prasadp4009/tt_um_pemu/docs/OPEN_ITEMS_AUDIT.md

# tt_um_pemu — Functionality Open-Items Audit, 2026-10-29

Branch: `docs/readme-site` (from `main@abafd1c`, the merged IMEM-512 design).
Scope rule for this pass: **no changes to `src/` RTL or `src/config.json`, ever.**
Test-only and docs-only changes only. Any RTL change below is a **proposal**,
never a commit. Nothing was merged to `main`; `main` was not touched;
repo visibility and Pages settings were not touched; no force pushes.

Evidence base: `SUBMISSION_READINESS_2026-10-27.md`, `PUSH_PREP_AUDIT_2026-10-26.md`
§15–§18, `FINAL_STATS.md` §5/§8, `ISA_v0.2.md`, `ISA_v0.3_NOTE.md`,
`STRETCH_PROTOCOL_TESTS_2026-10-27.md` + `stretch_results/`, plus fresh
re-runs done for this audit (see §4). All file paths below are repo paths
unless prefixed `masters:` (the firmware masters are now committed to this repo under `firmware/` - strip the prefix to resolve the path).

## 1. Classification key

- **(a) IMPACTS CHIP FUNCTIONALITY** — must close, or bound with proof.
- **(b) DOCUMENTED LIMITATION** — behavior as-designed / as-built and bounded;
  stated plainly, with the exact bound.
- **(c) NON-FUNCTIONAL** — cosmetic / admin / score / verification depth;
  not a chip bug.

## 2. Disposition table

| # | Item | Class | Disposition (evidence / resolution) |
|---|---|---|---|
| 1 | T17 WAIT-overflow semantics (tsel 2/3: 65536 / 1048576-cycle timeouts vs 16-bit Rd) | **(a) decision item — bounded, not silently wrong** | **What the hardware DOES today (read from RTL, proven by bench):** `src/tt_um_pemu_pe.v` implements only two presets: `wait_timeout_r <= instr[13] ? 4096 : 256` (13-bit). `tsel[1]` (`instr[14]`) is **ignored for the timeout and sets CONFIG_ERR sticky** (PE header: "T17-OPEN: tsel[1] ignored for the timeout; flag it instead of inventing semantics"). So: tsel 0 → 256, tsel 1 → 4096, tsel 2 → 256 + CONFIG_ERR, tsel 3 → 4096 + CONFIG_ERR. Elapsed is written as `{3'd0, ecnt}+1` on a hit or `{3'd0, wait_timeout_r}` on timeout; the largest value ever written is **4096**, so **no wrap and no overflow can occur in the as-built design** — the 16-bit Rd overflow question only arises if the 65536/1M presets are ever implemented. The standing "saturate at 0xFFFF" recommendation is therefore **not implemented, and not applicable to the shipped behavior**; it is the specified behavior for Option B below. Bench proof this pass: `test/tb_pe.v` Part 4 checks tsel=1 at exactly 4096 cycles / elapsed=4096 / TIMEOUT set, and tsel=2/3 CONFIG_ERR set; full bench re-run 2026-10-29: **RESULT: PASS (363 checks)**. **No RTL change made.** Decision for the ISA lead (see §3.1): Option A (recommended for submission) — rule tsel 2/3 out of the submitted ISA, document CONFIG_ERR+fallback as the behavior, firmware chains tsel=1 waits (as the UART break rule already does); zero cost. Option B — implement the presets with saturation; exact fix + re-verification cost in §3.1. **Also note a numbering collision:** ISA_v0.2 §"proof obligations" reuses the label T17 for Observer adjacency (trigger→commit ≤ K=6); that is a different, already-specified item (R-13) and is not this item. |
| 2 | CAN DLC ≤ 2 cap | **(b) DOCUMENTED LIMITATION** | **Bound: max DLC = 2.** Structural cause confirmed from `masters:firmware/can/can.asm` header + `stretch_results/can.md` §5: Tarang has **no data RAM** and all **16 GPRs are fully allocated** (register map in can.asm); the destuffed data stream (up to 16 bits) must survive SOF..DLC intact in a register while the DLC field's own shifter, the ID shifter, and the arbitration flag are also live; the only spare byte-wide homes are observer sregs, and a 16-bit stream cannot be reloaded from 8-bit sregs inside the inter-bit gap. DLC > 2 arguments are consumed and discarded and the firmware PUSHes 0xFFFF. The 255/256-word budget pressure at baseline was a second, contributing reason; **the GPR reason is binding, so IMEM-512 does not lift the cap.** All other CAN fields are DLC-independent loops, so this is a data-length limit only: CAN 2.0A TX + ACK + arbitration at 1 Mb/s is proven (wire CRC 0x33ea == recomputed). **Redesign is OUT of scope:** it would need a data-RAM-backed buffer or an additional 16-bit stream register plus a re-timed cell loop and a firmware rewrite. Plain-language bound also in `docs/CHARACTERIZED_LIMITS.md`. |
| 3a | Golden sub-check: test_spi 1-cycle stale assertion | **(c) checker bug — FIXED this pass** | **Root cause (harness, not chip):** the checker expected inter-byte SCLK gap 57 cycles / cycles-per-byte 407 (= 400+7), but the golden model itself produces **58 / 408 (= 400+8)** — exactly +1 cycle in the byte prologue/epilogue path. Re-run before fix (2026-10-29): `SCLK period deviations (want 50, 57 at byte boundary): [(7, 58)]`, `cycles/byte=408, want 407`; **every functional check passed** (MOSI bytes 0xA5/0x3C, TX words 0x5A/0xC3 + statuses, CS# windows, duty 25/25, halt, no stickies). Cross-proof the design is not at fault: co-sim SPI is **855/855 cycle-exact RTL-vs-golden**, so RTL and golden model agree; only the checker's expectation was stale. **Fix:** `masters:firmware/tests/test_spi.py` 57→58, 407→408 (exact patch in `docs/open-items/test_spi_checker_fix.patch` on this branch; the golden tests now live in the repo at `firmware/tests/`). Re-run after fix: **[PASS] spi, 881 cycles, halted, zero deviation** (`14x50c + 1x58c`, `cycles/byte = 408`). Repo `docs/FIRMWARE.md` SPI line corrected on this branch (407→408). The `firmware/spi/spi.asm` header comment now says 408/58, consistent with the corrected expectation (docs-only change; it does not affect any shipped hex). |
| 3b | Golden sub-check: test_uart TX-underrun sub-check | **(b) DOCUMENTED FIRMWARE LIMITATION — not a checker fix** | **Root cause (real firmware behavior, not a stale expectation):** the test expects a starved host (N=2, one data word) → PUSH 0xFFFD, no hang. Re-run 2026-10-29 reproduces the failure exactly: `TX underrun -> PUSH 0xFFFD, no hang (got [])`, `underrun run halted` FAIL; all other UART sub-checks pass. Mechanism: the RACE FIX (2026-09-27) guards **every** PULL with an RXNE wait (`jmp tx_d_have, rxne; jmp txloop` in `masters:firmware/uart/uart.asm`), so the TX loop **blocks forever waiting for byte 2** and never executes a PULL on an empty FIFO; the post-PULL RX_UNDERRUN check and the `tx_underrun` 0xFFFD path are, in the firmware header's own words, "retained as a safety net (unreachable in normal operation)". The golden model (`sim.py` PULL-on-empty → RX_UNDERRUN sticky) is correct but is never exercised on this path, and the peer never sees EVT 0 so it never pushes the halt word — hence "no hang" fails by construction. **No checker change made** (rewriting the expectation to "hangs" would gut the test) and **no firmware change made** (that would be a behavior change to shipped firmware, not a checker fix). **Documented bound:** in the UART TX demo, host starvation blocks in the RXNE wait; recovery is supplying the missing word (or host reset/reload) — there is no 0xFFFD abort on this path. Repo `docs/FIRMWARE.md` line "TX underrun → 0xFFFD, no hang" corrected on this branch to state the blocking behavior. Proposal + cost if the 0xFFFD abort is ever wanted: add a WAIT-bounded starvation timeout to the TX loop in firmware (firmware-only, no RTL), re-assemble, re-run golden + co-sim (UART trace re-record, 8,747 cycles), full regression gate; decision for the firmware owner. This is a firmware-demo limitation, not a PE bug: the PE executes the wait loop exactly as written. |
| 4 | Slow-corner timing: 512-build WNS −2.824 ns, 112 violators | **(a) genuine silicon-risk item — mitigated by clock guidance, redesign OUT of scope** | Numbers are the **IMEM-512 (submittable) run** (`FINAL_STATS.md` §8, run 40699493628): slow corner (nom_slow 1.08 V, 125 °C) setup WNS **−2.824 ns**, TNS −157.48 ns, **112 violators** (110/112 from `u_imem/A_DOUT[17]`, 2 reg-out from `A_DOUT[18]` — same fetch-path single-bit class as the 256 baseline's 131 violators all from A_DOUT[18]). Implied slow-corner fmax = 1/(20 ns + 2.824 ns) ≈ **43.8 MHz** (baseline was −2.933 ns / 131 / ≈43.6 MHz). Typical (+5.713 ns) and fast (+8.578 ns) corners are clean; **hold is clean at all corners**. The competition imposes **no clock target** (designer-chosen 50 MHz in `info.yaml`); these are checker warnings in this flow, not flow errors, and GDS/LVS/DRC/antenna/IR all pass. **Characterized guidance (also in `docs/CHARACTERIZED_LIMITS.md`): run at ≤ 43.8 MHz for guaranteed setup across all corners; 50 MHz is met with margin at typical and fast corners only.** Timing-closure redesign (fanout buffering/replication of the fetch net, or fetch pipelining) is OUT of scope for this pass and is the one item that would need a new hardening round if pursued. Max-slew slow-corner warnings (779, vs 587 baseline) are the same warning class, not errors. |
| 5 | SPI @125 MHz baseline anomaly (deterministic FAIL 13/15, fail_code 0x13) | **(b) OBSERVED, NOT ROOT-CAUSED — not claimed fixed** | Baseline (256-word) behavior: deterministic FAIL at 125 MHz, fail_code 0x13 (13/15 runs; working suspicion was MMCM/pin-sampling, never proven). On the 512 build it **did not reproduce: PASS 2/2** — `fpga/logs/test512_spi_125.log` and `test512_spi_125_rerun.log`, both `PASS: milestones 0x7fff as expected, signature=0xa6b864d9` (the 50 MHz reference signature, bit-identical). **Disposition, stated exactly: observed, not root-caused; no fix was attempted and none is claimed.** The re-synthesized 512 build differs in LUTRAM placement/inference, which is a hypothesis for the difference, not a root cause. The anomaly stays on the record as a 125 MHz operating-condition caveat: the proven operating point is 50 MHz (15-milestone SPI proof); 125 MHz passed twice on the 512 build but is not characterized as a guaranteed operating point. |
| 6 | Observer hardware capture (real trace-SRAM dump from the board) | **(c) SCORE ITEM — not done; NOT feasible in this pass without a harness build** | Status unchanged: Observer works in sim/co-sim (bench `tb_observer`, 35 checks; co-sim traces), but **no hardware trace-SRAM capture has ever been demonstrated**. Feasibility assessment (this pass, no RTL touched): **not feasible as a small add-on.** The programmed Zybo harness (`fpga/emu_tt_top.v` + `fpga/emu_tt_loader.v`, bitstream `fpga/emu_tt_50.bit`) has **no RD_TRACE path**: the loader FSM implements LOAD_IMEM / VERIFY / GO / TRANSFER / RD_TXFIFO only (grep: zero RD_TRACE references in the loader), and its VIO observation registers (`dbg0/dbg1/dbg2`) carry loader/SPI state, not trace data. The host protocol itself **does** support RD_TRACE (command 0x07 in `src/tt_um_pemu_host.v`, S_RSI/S_RCT/S_RPRE/S_RTRC/S_RTRD/S_RTRN/S_RTRP states), and PE firmware **can** configure the Observer via MSR (TRIG_MODE/EDGE_MASK/OBS_CTL sequence), so the silicon path exists — but using it on the board needs (1) a new firmware image that configures the Observer then runs a protocol and halts, (2) a loader-FSM extension to issue RD_TRACE after halt and stream the 5-byte entries out via VIO, and (3) a Vivado rebuild + Zybo run + validation. That is a scoped harness build (firmware + loader + rebuild + validation; Vivado 2026.1 + license confirmed present on starklabs), **not** a capture that can be produced from the existing bitstream — BRAM contents are not readable over JTAG without a debug path. **Left as the named remaining score item**, with the scoped proposal above. No capture evidence is committed by this pass, and none is claimed. |
| 7a | T17 siblings T5/T6/T7/T10/T11 (ISA §8 TBDs) | **(b) IMPLEMENTED BEHAVIOR — ISA table stale, no RTL change needed** | RTL already defines each: T5 unallocated sregs → **read-as-zero** (`sreg_read` default); T6 illegal opcodes 24–63 → **NOP (1+d) + CONFIG_ERR**; T7 logic fn=11 → **executed as AND + CONFIG_ERR** (PE header); T10 RET on empty stack → **NOP + CONFIG_ERR**; T11 CALL stack overflow → **drop call + CONFIG_ERR** (not the proposed STATUS[6]=CALL_OVF — the flag was never assigned, CONFIG_ERR is the implemented signal). The ISA §8 table still lists them "open"; a doc addendum (this audit + `docs/CHARACTERIZED_LIMITS.md`) closes the table. No RTL change, no re-verification beyond the existing benches that already cover these paths. |
| 7b | T17 siblings T2/P1 (SLEEP cycle-count tension), T3, T4, T8, T9, T12, T13, T14, T15, T16 | **(b)/(c) — spec tension / unruled / verification depth; none is an observed chip misbehavior** | T2/P1: SLEEP is built as exactly `1+imm13` with `d` reserved_zero ignored; the tension is between two spec sentences ("every insn = 1+delay" vs SLEEP = 1+imm13), not between RTL and test — doc/contract wording item for the ISA lead + formal (F1 must encode the resolution). T3 (CFG_DIRTY clear condition), T4 (OBS_ARM one-shot vs sticky), T8 (PDIR/PMASK/PMODE reset-default confirmation), T16 (HLT/GO wake accounting): unruled, no failing test or observed misbehavior on record; ruling needed before formal closure, not a submission gate. T9 (formal SVA bind names): verification depth. T12 (pin-effect list naming only PSET/PSETR): **doc fix only** — add PDIR/PMODE to ARCHITECTURE §2.2.2 list. T13 (Q5 sequence triggers), T15 (watermark async push): feature proposals, out of scope; sticky-poll TRACE_WM works as built. T14 (Q4 PE-side trace read): decided v0.2 — host-only read stands; revisit gate not met. |
| 7c | PULSE-mode PIN_SEL tied to 0 (top-level integration deviation) | **(b) DOCUMENTED LIMITATION** | `src/tt_um_pemu.v` ties observer `pin_sel` to `3'b0` because the PE port list does not expose `pin_sel_r` (PE sreg PIN_SEL 0x0A itself reads/writes correctly). Consequence, bounded: **PULSE-mode triggering watches pin 0 only**, regardless of the MSR PIN_SEL value; EDGE and PATTERN modes are unaffected (masks only). Proposal (RTL, not done): add a `pin_sel_r` PE output and wire it through; re-verification = observer bench + top bench + CI round. Until then the bound is: PULSE source = pin 0. |
| 7d | TRACE_WM semantics (D7 erratum) | **(b) RESOLVED, documented** | Resolved doc-side 2026-10-26: STATUS[12] TRACE_WM is sticky, cleared only by OBS_CLR (MSR OBS_CTL bit 2), not by STATUS W1C (bits [4:0] only). OBS_PTR saturates at 204, never wraps. No action. |
| 7e | USB RX / merged USB; 10BASE-T Ethernet | **(b) DOCUMENTED LIMITATIONS (firmware/scope, not chip bugs)** | Merged USB TX+RX in one image is proven on the 512 build (299-word merged image; 301-word variant proves `ahi=1` chunk-base load/verify on Zybo; co-sim usb_full 6,297 cycles). A complete USB device stack remains firmware work. 10BASE-T is not feasible on-chip on three independent grounds (Manchester half-bit 2.5 cycles on the 20 ns grid = ±10 ns jitter vs ±5.5 ns 802.3 limit; exact Manchester needs a 100 MHz grid vs ~43.8 MHz slow-corner fmax; 10BASE-T needs an analog PHY, not digital GPIO) — external-PHY-over-MII would work but is not an ISA achievement and is not claimed. |
| 7f | Formal competition entry (Jane Street form) | **(c) NON-FUNCTIONAL / ADMIN — OPEN, largest admin gap** | No formal entry submitted as of 2026-10-27; the 2026-09-27 competition-updates signup (prasadp4009@gmail.com) is not the entry. The form is not yet published by Jane Street; **deadline 2027-01-18**. Owner: Prasad (submitter). A perfect chip with no entry scores zero. |
| 7g | Viewer job / GitHub Pages | **(c) NON-FUNCTIONAL — OPEN, submitter's settings call** | Every CI round: gds ✅, precheck ✅ (9/9), gl_test ✅, test ✅, docs ✅, viewer ❌ — solely because GitHub Pages is not enabled on the private repo. Cosmetic (renders the GDS viewer page); the flow's own render PNG exists in run artifacts. Deliberately not changed in this pass (repo visibility/Pages settings out of scope). |
| 7h | Display-name rename (Tarang collision) | **(c) NON-FUNCTIONAL — undecided** | Another public project uses "Tarang". Repo name `tt_um_pemu` is fixed by Tiny Tapeout convention regardless; only the display name is at stake. No chip impact. |
| 7i | PROGRESS.md markers | **(c) NON-FUNCTIONAL — stale** | PROGRESS.md still shows Phase 6/7/8 "queued" markers that postdate completed work (RTL, verification, hardening all executed). Cosmetic tracker staleness; refresh is a Phase B docs task, not a chip item. |
| 7j | Local hardening (Phase 0, docker group) | **(c) NON-FUNCTIONAL — convenience, still blocked** | `jarvis` is not in the `docker` group on starklabs; unlock is `sudo usermod -aG docker jarvis` (~1 min, Prasad). CI hardening works (~40–70 min/run), so this is iteration convenience, not a blocker. |
| 7k | Upstream template issue (gl_test `sg13cmos5l_udp.v` omission) | **(c) NON-FUNCTIONAL — drafted, unfiled; repo-side fix in place** | Root cause was the Tiny Tapeout template Makefile omitting the PDK's mandatory sibling file (2,261 unknown-module errors). Repo-side one-line fix (commit e99ff28, `test/Makefile` GATES sources) is in place and gl_test is green on every round since; the durable upstream fix (draft issue text in the readiness doc) remains unfiled — upstream hygiene, not a chip item. |
| 7l | Phase 7 verification depth (formal timing contract, constrained-random, agentic campaign) | **(c) VERIFICATION DEPTH — queued, not started; not a chip bug** | Existing evidence is already strong (643 benches, formal 32/32 on the ISA-contract subset, co-sim 11/11 cycle-exact, 4 protocols on Zybo hardware + stretch protocols in sim). Phase 7 adds depth, not existence. Not attempted in this pass per instructions. |
| 7m | Vacuity code 0x0E vs 0xEE | **CLOSED** | Hardware produces 0xEE (HALT-status mismatch → T_DG diagnostic drain → do_fail(0xEE)); 0x0E was the ACK-timeout code only. `fpga/test_tt.tcl` expectation fixed on the 512 branch and re-proven on hardware; audit §18 records the semantics call closed. |
| 7n | Local-master housekeeping: `firmware/i2c/i2c.hex` stale vs `.asm` | **(c) NON-FUNCTIONAL — note only** | Repo `i2c.hex` matches the current `.asm` and is byte-identical to a fresh assembly, as are all repo hex files. The stale file is in local masters only; no shipped artifact is affected. |
| 7o | FPGA negative-WNS warning class (e.g. usb_full proj −5.837 ns) | **(c) NON-FUNCTIONAL for the ASIC** | FPGA-harness timing warnings (LUTRAM RMW paths); hardware passes regardless, as on the baseline. This is not ASIC STA — the ASIC timing verdict is item 4. |

## 3. RTL-needing proposals (NOT committed — decision items only)

### 3.1 T17 Option B — implement 65536/1M presets with saturation (only if the ISA lead wants the presets)

Exact fix (PE only, `src/tt_um_pemu_pe.v`):
1. Widen `wait_timeout_r` and `ecnt` from 13 bits to 21 bits (1,048,576 needs bit 20 for the value itself).
2. Timeout map: tsel 0 → 256, 1 → 4096, 2 → 65536, 3 → 1048576; remove the `instr[14]` CONFIG_ERR set for tsel 2/3 (keep CONFIG_ERR for genuinely reserved encodings elsewhere).
3. Elapsed write, both exits: `Rd <= min(elapsed, 16'hFFFF)` — i.e. on timeout write `16'hFFFF` (not the timeout value) with TIMEOUT sticky set; on a hit write `min(ecnt+1, 16'hFFFF)`. TIMEOUT sticky already disambiguates a saturated timeout from a genuine 0xFFFF hit only when combined with the sticky bit — document that TIMEOUT must be read alongside Rd for tsel 2/3.
4. Spec updates (docs-only, same change): ISA timeout table, T2, `isa_v0.2.yaml` `wait_tsel_map`, and the T17 row — a semantics change, so it forces an ISA version bump per ISA_v0.2 §10.

Re-verification cost: update `test/tb_pe.v` Part 4 (tsel 2/3 CONFIG_ERR checks become 65536/1048576-cycle timeout checks — 1M-cycle Verilator runs are cheap); update the golden model `sim.py` WAIT path and re-run all golden protocol tests; re-record any co-sim traces containing WAIT (cycle counts change only for tsel 2/3 images; none of the shipped protocol images use tsel 2/3 — UART uses tsel ≤ 1 everywhere per its header); full regression gate (643 benches, formal 32/32 incl. F4 WAIT properties, 11/11 co-sim); one CI round (gds/precheck/gl_test/test/docs, ~40–70 min). No GDS-significant change expected (small PE logic delta), but CI re-hardening is mandatory because `src/` changed. Zybo re-proof is not required unless firmware changes (it does not).

### 3.2 PULSE pin_sel wiring (item 7c)

Add a `pin_sel_r` output to the PE port list, wire it to the observer `pin_sel` input in `src/tt_um_pemu.v` (replacing the `3'b0` tie), re-run observer + top benches + one CI round. Small, but it is an RTL change and was not made in this pass.

### 3.3 UART TX starvation timeout (item 3b, firmware — not RTL)

If the 0xFFFD abort is wanted: add a WAIT-bounded starvation timeout to the TX data-wait loop in `masters:firmware/uart/uart.asm`, re-assemble, re-run golden UART + co-sim UART (8,747 cycles, trace re-record), full regression gate. Firmware-only; no `src/` change, but it does change a shipped `.hex`, so it needs the same gate discipline as an RTL change.

## 4. Local tests run for this audit (2026-10-29, branch `docs/readme-site` unless noted)

| Test | Result |
|---|---|
| `bash test/run_verilator.sh pe` (starklabs, Verilator 5.053) | **RESULT: PASS (363 checks)** — includes tsel=1 4096-cycle/elapsed/TIMEOUT checks and tsel=2/3 CONFIG_ERR checks (Part 4). `check()` sets a fail flag on any miss, so PASS means all of them passed. |
| Golden `test_spi.py` via `firmware/tools/tb.py run` — BEFORE checker fix | **FAIL, exactly as documented**: `SCLK period deviations (want 50, 57): [(7, 58)]`, `cycles/byte=408, want 407`; all functional checks passed. |
| Golden `test_spi.py` — AFTER checker fix (57→58, 407→408) | **[PASS] spi, 881 cycles, halted** — `14x50c + 1x58c`, `cycles/byte = 408`, zero deviation. |
| Golden `test_uart.py` via `tb.py run` — re-run, no changes | **FAIL only on the TX-underrun sub-check** (`PUSH 0xFFFD, no hang (got [])`, `underrun run halted` FAIL); every other UART sub-check passes (TX bytes/framing, RX words, EVT 0/1/2, zero warnings, WAIT latency 2 cycles, CAP ts match, RX sampling +1 cycle). |
| SPI @125 MHz log re-read (`fpga/logs/test512_spi_125.log`, `..._rerun.log`) | Both `PASS: milestones 0x7fff, signature=0xa6b864d9` — confirms the 2/2 non-reproduction cited in item 5. No new hardware run was made in this pass. |

No other local test was run in this pass. In particular: no Zybo run was attempted (item 6 needs a harness build first), no CI round was triggered (docs-only + patch-file changes do not alter hardening inputs; CI re-verification of the branch is a Phase B/C step if desired), and no RTL was modified, so no RTL re-verification was owed.

## 5. Bottom line — what still impacts chip functionality after this pass

**No unhandled chip-functionality bug remains.** The complete list of functionality-affecting items is:

1. **Slow-corner timing (item 4)** — the one genuine silicon-risk item: guaranteed setup across all corners needs **≤ 43.8 MHz**; 50 MHz is good at typical/fast only. Mitigation is the clock guidance, not a redesign (redesign out of scope).
2. **T17 (item 1)** — a decision item, not a bug: the as-built behavior (256/4096 + CONFIG_ERR fallback) is safe and proven; the ISA lead must choose Option A (rule the presets out, zero cost) or Option B (implement + saturate, cost in §3.1). Until ruled, firmware must not use tsel 2/3 expecting a 65536/1M timeout — it will get 256/4096 + CONFIG_ERR instead.
3. **Documented limitations (items 2, 3b, 5, 7c, 7e)** — CAN DLC ≤ 2; UART TX host-starvation blocks instead of aborting with 0xFFFD; SPI @125 MHz passed 2/2 on the 512 build but is observed-not-root-caused (proven point is 50 MHz); PULSE-mode trigger watches pin 0 only; full USB device stack / 10BASE-T out of scope. Each is bounded in `docs/CHARACTERIZED_LIMITS.md` with the exact behavior a user or judge will see.

Everything else in the table is non-functional, administrative, verification depth, or already closed. The remaining **score** item (not a chip bug) is the **Observer hardware capture (item 6)**; the remaining **admin** item is the **formal competition entry (item 7f, deadline 2027-01-18)**.
