prasadp4009/tt_um_pemu/docs/assets/chip_3d_view.png

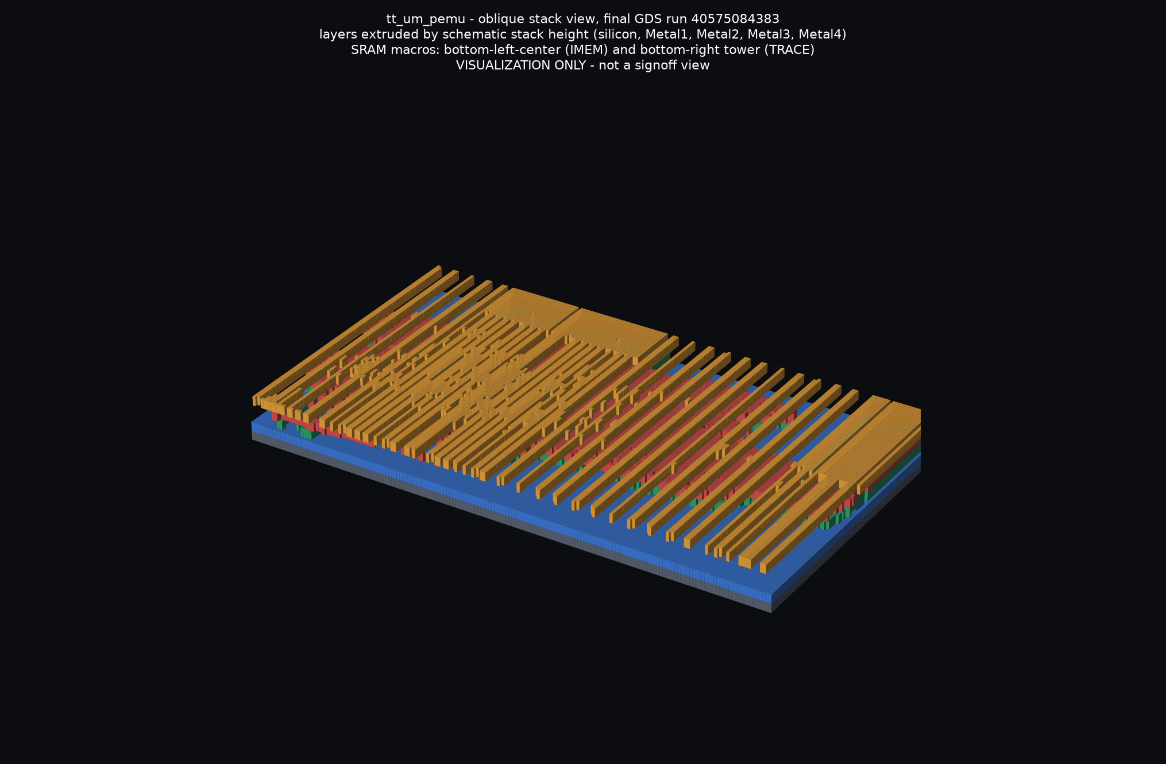
docs/assets/chip_3d_view.png
