prasadp4009/tt_um_pemu/test/synth/tt_flow/metrics.csv

Metric | Value
design__lint_error__count | 0
design__lint_timing_construct__count | 0
design__lint_warning__count | 2
design__inferred_latch__count | 0
design__instance__count | 11964
design__instance__area | 184656.742200
design__instance_unmapped__count | 0
synthesis__check_error__count | 0
