prasadp4009/tt_um_pemu/(commit log)

2026-09-27 Worker C (host): 2-wire host port, FIFOs, IMEM loader, trace readout
    - UART-style 10-bit framed host link on ui_in[0]/uo_out[0] with autobaud
    sync (0x00 NOP), default 64 clocks/bit, clamp 16..4096
    - Framed protocol [CMD][LEN][DATA]->[ACK][DATA]: NOP, LOAD_IMEM (PROG
    full-word prog_wen strobes), WR_RXFIFO (MSB-first, odd-pad 0x00,
    all-or-nothing), RD_TXFIFO, RD_TRACE (ret_count clamp + OBS_PTR),
    RD_STATUS, GO, HALT_REQ (accepted); unknown/bad-len -> NACK_ERR
    - 16x16 RX/TX FIFOs: PE push-full drops, pull-empty returns 0, never stalls
    - RD_STATUS byte {PE_RUNNING,PE_HALTED,TIMEOUT=0,TX_EMPTY,RX_FULL,
    TRACE_WM(live),TRACE_FULL,CONFIG_ERR=0}
    - Event-flag capture (no v0.2 host clear path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
    [tb_host.v, tt_um_pemu_host.v]
2026-09-27 Worker B: TEMPO Observer capture engine + trace SRAM port
    204-entry 40-bit trace SRAM controller (RM_IHPSG13_1P_1024x8, single port).
    EDGE/PATTERN/PULSE triggers per ISA v0.2 s6; trigger->commit K<=6 core
    cycles; 1-deep latest-wins pending latch; OBS_PTR saturates at 204 (no
    overwrite); watermark/full event strobes to PE STATUS; obs_clr handling.
    Host readout allowed during capture per YAML read_trace.busy_rule
    (coordinator correction): writer-priority arbitration, ack delayed (never
    dropped/out-of-order), host block owns the 256-cycle NACK_BUSY timeout.
    Q4: no PE<->trace data path (host-only read).
    Self-check: 13-scenario Icarus TB vs sim.py golden (trigger modes, trace
    contents, watermark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
    [tt_um_pemu_observer.v]
2026-09-27 RTL: PE core tt_um_pemu_pe.v (Worker A) — 24 opcodes, T1-T17, CSR file, amendments (prog_dout/halt_req/timeout_sticky/config_err)
2026-09-27 Worker D: top-level tt_um_pemu.v + block benches + SRAM sim models
    - src/tt_um_pemu.v: integrates PE + Observer + host with both IHP SRAM
    macros (A_DLY=1, BIST tied off); amendment ports wired (prog_ren/dout,
    halt_req, tx_empty/rx_full, timeout_sticky, config_err); Q4 structural
    invariant documented (no PE<->trace-data path)
    - test/tb_top.v: full-chip bench (HALT_REQ, LOAD/VERIFY/GO, pin/TX echo,
    RD_TRACE, RD_STATUS) via host UART model
    - test/tb_pe.v, test/tb_observer.v: block benches vs intf contracts
    - test/sram_sim.v: sim-only functional models of both macros
    - test/{asm,hex}/: bench programs assembled from isa_v0.2.yaml
    - scripts/q4_check.py: structural Q4 invariant checker
    - te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
2026-09-27 Lint-clean: tie off macro A_BIST_DOUT, sram_bb.v blackboxes, waiver syntax
    - Verilator 5.053 -Wall lint of full design now passes with ZERO warnings
    - test/sram_bb.v: lint/synth blackbox stubs for both IHP SRAM macros
    (empty modules; self-exempt from UNUSEDSIGNAL/UNDRIVEN/DECLFILENAME)
    - test/lint_waivers.vlt: rewritten with valid verilator_config syntax
    (this build accepts -rule/-file/-line only; -match/-msg are syntax errors)
    - src/tt_um_pemu.v: macro A_BIST_DOUT tied to _nc wires (BIST disabled)
    - scripts/q4_check.py: PASS (no PE<->trace-data path)
    [sram_bb.v, tt_um_pemu.v]
2026-09-27 sram_sim.v: add missing A_BIST_DOUT ports (present on real macro)
    [sram_sim.v]
2026-09-27 Fix tb_top UART/TB races, PDK SRAM interface, GO/WR_RXFIFO ordering
    - Remove false A_BIST_DOUT from PDK SRAM interface (not in real macros)
    - tb_top: drive UART on negedge, always-on RX queue, fix sampling races
    - tb_top: GO before WR_RXFIFO (WR_RXFIFO is RUN-only per ISA)
    - top_smoke.asm: spin on RXNE before each PULL (no fill-vs-pull race)
    - tb_top: resync autobaud after long VERIFY (sync_armed re-arm)
    - Pad hex files to 64 words (remove readmemh warnings)
    tb_top: 68 checks PASS. tb_pe/tb_observer/tb_host still PASS.
    [sram_bb.v, sram_sim.v, tb_top.v, tt_um_pemu.v]
2026-09-27 Fix PE imem prefetch: use pc (not pc_plus1) for ST_DELAY/ST_SLEEP
    Co-sim found systematic bug: during ST_DELAY/ST_SLEEP, pc is already
    advanced at entry, so prefetching pc_plus1 skips an instruction.
    ST_WAIT is correct with pc_plus1 (pc not advanced at entry).
    Fixes SPI cycle-8 mismatch (pmask 0x2C vs 0xFF, r15 0x0000 vs 0x0001).
    [tt_um_pemu_pe.v]
2026-09-27 PE area opts + 2 pre-existing bug fixes (carry, HLT)
    Area optimizations (behavior-preserving):
    - Shared GPR read ports: rf_rd0/rf_rd1/rf_rd2 replace 9 duplicated
    regs[instr[20:17]] decoder/mux instances
    - Shared add/sub: single 17-bit adder with conditional inversion
    (was separate add_r and sub_r datapaths)
    - Shared barrel shifter: shr via bit-reversal + single left shifter
    (was separate left/right shifters)
    Pre-existing bug fixes (found via co-sim vs sim.py golden):
    - SUB/CMP C flag was inverted (~sub_r[16]=borrow); ISA requires
    C=1 if a>=b (carry-out). Fixed to sub_r[16].
    - HLT incremented PC (pc_plus1); sim.py golden does not increment.
    Fixed to hold PC at HLT instruction.
    Ver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
    [tt_um_pemu_pe.v]
2026-09-27 formal: add 12 extended proofs (carry, HLT, prefetch, illegal opcode, FIFO, watermark) + xcheck
    - 12 new SymbiYosys BMC proofs: SUB/CMP/ADD carry semantics (C=1 iff a>=b),
    HLT PC hold, prefetch mux in DELAY/WAIT/SLEEP, illegal-opcode NOP+CONFIG_ERR,
    host TX/RX FIFO invariants, observer watermark exact-threshold + disabled.
    - All 32 proofs PASS (20 existing re-run + 12 new), all bounded BMC.
    - Formal $isunknown no-X proof abandoned: yosys smtbmc mis-evaluates
    $isunknown on wires (minimal reproducer); replaced by test/xcheck_pe.v
    (Icarus 4-state, 600 cycles, PASS).
    - README results table updated with depths and bounded status.
    Author: Prasad Pandit
    [cap_atomic.sv, carry_add.sv, carry_sub.sv, carry_sub2.sv, fifo_rx.sv, fifo_tx.sv]
2026-09-27 Extend Verilator block benches: PE 352 checks, Host 136 checks, add COVERAGE.md
    - tb_pe.v: 352 checks PASS (was 19). Added coverage for ALU, control flow,
    pins, SLEEP/WAIT, EVT, MRS/MSR, halt_req, observer interface. Fixed
    WAIT encoding, MRS/MSR low-byte semantics, SLEEP/WAIT cycle counts,
    evt_clr state, obs_clr single-program, halt_req boundary.
    - tb_host.v: 136 checks PASS (was 127). Added FIFO 15/16/17 occupancy,
    LOAD_IMEM one/zero/odd, VERIFY_IMEM one word, UART framing-error drop,
    break recovery.
    - test/COVERAGE.md: Functional checklist, T17 open item, RTL deviations,
    fixed-bug regressions, bench commands.
    [tb_host.v, tb_pe.v]
2026-09-27 cosim: cycle-exact RTL-vs-golden replay, 4/4 firmware images 100% pass
    Adds the cocotb co-simulation testbench (PE+observer vs sim.py golden
    traces): test_cosim.py, cosim_top.v, Makefile.
    WAIT-exit sampling fix: sim.py commits a WAIT's effects (pc+=1, Rd<-elapsed,
    TIMEOUT sticky) after its last tick with no tick of their own, so the
    golden record at the exit tick is pre-commit; the RTL commits the same
    effects on the exit clock edge (the only T2-consistent implementation -- a
    deferred commit would add a bubble and violate 1..1+timeout occupancy).
    The testbench detects WAIT-exit ticks (golden decode + ST_WAIT->ST_BASE
    edge confirmation) and skips pc/Rd/sticky[0] there; those effects are
    veri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
    [cosim_top.v, test_cosim.py]
2026-09-27 tt: standalone template sim wired to tt_um_pemu via host port
    Replace the stock Tiny Tapeout adder test with a real end-to-end
    integration test that drives the chip exclusively through its
    TT-visible pins:
    - reset, autobaud sync (0x00), RD_STATUS in PROG mode
    - LOAD_IMEM the SPI firmware image, VERIFY_IMEM bit-exact readback
    - GO, check PE_RUNNING
    - WR_RXFIFO the single-word HALT firmware command, check PE_HALTED
    - pre-load a TRANSFER command while halted, GO to wake, capture the
    SPI transaction on uio pins (16 SCLK edges, MOSI=0xA5,0x3C MSB-first)
    - RD_TXFIFO: result words must be 0x0000 (MISO=0)
    The test is fully standalone (spec-driven from isa_v0.2.yaml and the
    RTL headers); it share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
    [tb.v, test.py]
2026-09-27 firmware: fix host/PE inter-word race (RXNE wait before every frame PULL)
    The serial host delivers 16-bit command-frame words ~2000 core cycles
    apart, but firmware pulled multi-word frames back-to-back (~5 cycles).
    A PULL on an empty RX FIFO returns 0 and sets RX_UNDERRUN, corrupting
    frames (found by the Tiny Tapeout template test).
    Fix (firmware only, ISA v0.2 unchanged): RXNE wait loop before every
    dependent frame-word PULL. New image sizes (all < 256 words):
    spi: 63 -> 71, uart: 119 -> 125, i2c: 199 -> 209, onewire: 130 -> 132.
    Verification:
    - New race regression (2000-cycle gapped frames): FAILS 4/4 on pre-fix
    images (RX_UNDERRUN + corrupted TX), PASSES 4/4 on fixed images.
    - Co-si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
2026-09-27 tt: chunk LOAD_IMEM/VERIFY_IMEM into <=63-word frames for larger firmware images
2026-09-27 FPGA emulation of TEMPO-32 on Zybo (xc7z010clg400-1)
    Self-contained Phase A+B self-test matching test/tb_top.v, with VIO
    control/status, ILA hooks, and per-frequency bitstreams.
    Hardware results (Zybo, 2026-09-27):
    - 50MHz: FAIL, fail_code=0x07 (Phase A 2nd status), WNS -0.679ns
    - 100MHz: PASS, fail_code=0x00, all 12 milestones, sig=0x9b5d3828
    - 125MHz: FAIL, fail_code=0x07, WNS -5.161ns
    - 150MHz: FAIL, fail_code=0x07
    Highest clean frequency: 100MHz
    Vacuity (100MHz): PROVEN - injected fault (exp 0x41) detected,
    fail_code=0x0F, Phase B correctly fails.
    Utilization (100MHz): 4837 LUTs (27%), 4702 regs (13%), 9.5 BRAM (16%).
    Bitstreams: fpga/emu_top_{50,100,125,150}.bit + .ltx
    Note: 50MHz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
    [emu_loader.v, sram_emu.v, tb_emu_loader.v]
2026-09-27 Real TT-flow synthesis report for tt_um_pemu (IHP SG13G2)
    Synthesize frozen TEMPO RTL through the actual Tiny Tapeout/LibreLane
    Classic flow (3.0.14) against ihp-sg13g2, top tt_um_pemu, SRAMs as
    blackboxes via test/sram_bb.v. Run tag tt_synth_0ca8496.
    Result: 11,964 instances (11,962 stdcells + 2 SRAM macros),
    184,656.74 um2 logic area, 0 unmapped cells, 0 latches, 0 check
    errors, 2 pre-existing lint warnings. Full method, environment notes
    (python-enabled Yosys 0.69+154 build, tkinter shim for PDK config.tcl),
    and caveats in test/synth/tt_flow/README.md. No RTL changes.
    [metrics.csv]
2026-09-27 Tiny Tapeout Zybo wrapper: 71-word SPI firmware HW test
    - emu_tt_loader.v: reproduces TT template test.py sequence (autobaud,
    RD_STATUS, 71-word load/verify, GO, HALT 0x00FF, WR_RXFIFO XFER,
    SPI pin capture, TXFIFO check). 15 milestones, signature, vacuity.
    - emu_tt_top.v: instantiates real tt_um_pemu with full TT interface
    (ui_in, uo_out, uio_in/out/oe, ena, clk, rst_n). VIO control/observe.
    - build_tt.tcl: Vivado project flow (like build.tcl) for xc7z010clg400-1.
    - test_tt.tcl: programs board via hw_server, pulses reset, runs test,
    reads milestones/signature/status via VIO.
    - tb_emu_tt.v: Icarus testbench (sim PASS: milestones 0x7fff, sig 0xa6b864d9).
    - spi_fpga.hex: 71-word firmwa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
    [emu_tt_loader.v, emu_tt_top.v, tb_emu_tt.v]
2026-10-26 fpga: case-ROM loader + per-protocol TT builds (Zybo HW campaign)
    emu_tt_loader.v: case-based img_word()/img_byte() ROM replaces the zero-synthesizing readmemh ROM (holds the 1-Wire image; regenerate per protocol with gen_fw_rom.py). build_tt.tcl gains PROTO arg + GENERIC_MODE + per-protocol bitstream names. Adds gen_fw_rom.py, run_build_{50,100,125,150}.sh, test_freq_dbg.tcl, spi_fpga_256.hex, clk_config.vh, rebuilt emu_top_50 pair, and the emu_tt_50 SPI pair as the tracked HW artifact. test_tt.tcl expectation semantics unchanged (0x0E vs observed 0xEE flag stays open).
    [emu_tt_loader.v, emu_tt_top.v, gen_fw_rom.py]
2026-10-26 test: synth scripts for IHP SG13G2 flow
    Yosys scripts reproducing the 11,416-cell mapped result (typ 1.20V/25C, 20ns) for tt_um_pemu + generic variant. Outputs (mapped netlist, logs, stats) are gitignored; these scripts regenerate them.
2026-10-26 docs: TEMPO datasheet + spec set
    docs/info.md written for the TT datasheet (was template stub). Adds ARCHITECTURE.md, ISA_v0.2.md, isa_v0.2.yaml, FIRMWARE.md from the specs repo. ISA_v0.2.md carries erratum D7 (2026-10-26): STATUS[12] TRACE_WM is cleared only via OBS_CLR, not STATUS W1C - doc corrected to match verified RTL/golden model, no RTL change, no firmware accesses the bit. test/README.md rewritten for the real test tracks.
    [isa_v0.2.yaml]
2026-10-26 chore: gitignore Vivado/tool build products
    Ignores ~1.8GB of build products (Vivado proj/jou/log, formal engine dirs, Verilator objects, synth outputs, coverage.dat). Negations keep the tracked emu_tt_50 SPI bitstream pair; emu_top_50_v2.ltx and ila_*.csv captures also ignored.
2026-10-26 tt: config.json - wire IHP SRAM macros (EXTRA_VERILOG_MODELS blackbox stubs + MACROS views, PDN macro connections, aligned PDN stripes)
2026-10-26 tt: config.json - move u_imem right (x 160.72 -> 205.68): the 10.48 um slot between the SRAM macros left a 5.76 um Metal1 channel pdngen could not repair (PDN-0179)
2026-10-27 tt: config.json - flip both SRAM macros N -> FS, positions unchanged (u_imem [205.68, 3.78], u_tmem [1127.36, 3.78]): all ~256 signal pins sit on the macros bottom edge (Metal2, y 0.0-0.26 in the LEF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
2026-10-27 tt: config.json - demand discipline (Step 2, same plan): MAX_FANOUT_CONSTRAINT 8, MAX_TRANSITION_CONSTRAINT 0.75, PL_RESIZER_SETUP_SLACK_MARGIN 0.25, RUN_POST_GRT_RESIZER_TIMING on, DRT_SAVE_DRC_REPO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
2026-10-27 tt: port Pettit ExtendPowerStripes + MouthKeepouts plugin (Step 3)
    Custom LibreLane steps from Ken Pettit's ihp-um-janestreet-prism
    (Apache-2.0, Copyright 2026 Ken Pettit): odb_stripes.py and
    odb_keepouts.py are his files verbatim; librelane_plugin_prism_pdn.py
    carries the two step classes wired in src/config.json
    (Project.ExtendPowerStripes after OpenROAD.GeneratePDN,
    Project.MouthKeepouts after Odb.ManualMacroPlacement) plus his netgen
    LVS-JSON escape repair (our SRAMs have the same VDD!/VSS!/VDDARRAY!
    pin names that corrupt netgen's JSON). His other steps (macro swaps,
    pin diodes, anchoring, chip art) are not used here and not ported.
    ExtendPowerStripes is the macro power feed: pdngen tr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
    [librelane_plugin_prism_pdn.py, odb_stripes.py]
2026-10-27 tt: config.json - wire Step 3 custom steps (meta.substituting_steps)
    flow Classic + Project.MouthKeepouts after macro placement and
    Project.ExtendPowerStripes after GeneratePDN, with Pettit's
    signed-off settings: EXTEND_STRIPES_SRAM_ARRAY_EVERY_OTHER on,
    ALL_COLUMNS off, PIN_FACE_MARGIN 0 (his value; plugin default 3);
    MouthKeepouts over the RM_ macros at width 40 / margin 20 / density
    cap 0.25. ERROR_ON_PDN_VIOLATIONS stays 0 (his value too): pdngen's
    connectivity check runs before the bridging step, so LVS + the final
    IR-drop report are the verdict. Nothing else changes: Step 1+2 config
    (FS orientations, fanout/resizer keys, density 50, halos 6/2,
    positions) untouched.
    Pre-push gate: plug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
2026-10-27 tt: odb_stripes.py - OUR stripe-centre clearance guard (Step 3.5)
    Modification of Ken Pettit's Apache-2.0 code (his headers/license
    unchanged; the added block and the tidy() call site are marked
    'OUR MODIFICATION (tt_um_pemu, 2026-10-27)').
    Defect (run 40520569898, audit section 12): tidy() replaced pdngen's
    partial-height VPWR segments at x=1283.04 um with a full-height stripe
    beside the VGND stripe at x=1284.48 um - centres 1.44 um apart - and
    their via/pad geometry bridged VPWR to VGND for the full core height.
    Magic extraction merged the two nets; LVS failed with 'Top level cell
    failed pin matching' (10 errors).
    Guard: never extend partial-height segments into a full-height stripe
    whos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
    [odb_stripes.py]
2026-10-27 tt: config.json - Step 4: waive Magic illegal overlaps, run KLayout CMOS5L DRC
    ERROR_ON_ILLEGAL_OVERLAPS: 0 with the waiver documented in-config:
    all 52 reports in run 40520569898 are 'Illegal overlap between obsm4
    and metal4 (types do not connect)' where the VPWR stripes cross the
    SRAM LEF abstracts' Metal4 OBS bar at the macros' own VDD columns -
    Pettit's documented waived case (22 in ihp-um-janestreet-prism); the
    GDS has no metal there. RUN_KLAYOUT_DRC: 1 with the cmos5l runset
    (pdk_dir::libs.tech/klayout/tech/drc/ihp-sg13cmos5l.drc, Pettit's
    exact settings) so the real DRC verdict - the precheck deck - runs
    in-flow instead.
    Pre-push gate: plugin imports + flow substitution verified, gua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
2026-10-28 imem512: swap u_imem to RM_IHPSG13_1P_512x32_c2_bm_bist (same placement 205.68,3.78 FS) + blackbox/sim models
    [sram_bb.v, sram_sim.v]
2026-10-28 imem512: COS2 co-sim format (pc u16), all traces re-recorded cycle-exact; stretch + merged USB (299 words) hex/traces; cosim_top widened to 512 macro
2026-10-28 imem512: commit the Zybo FPGA port of the 512-word design (Phase 6)
    sram_emu.v: RM_IHPSG13_1P_512x32 BRAM model mirroring test/sram_sim.v. emu_tt_loader.v: 9-bit chunk addressing -- chunk base/n registers were [7:0] (240+60 wrapped to 44) and the LOAD/VERIFY frame ahi byte was hardcoded 8h00, so the loader physically could not address >=256; it now emits {7b0, base[8]} and all chunk arithmetic is widened. Fail-code map untouched.
    gen_fw_rom.py: 9-bit ROM index; usb_full/ubproof/usb_full301 images added. build_tt.tcl: GENERIC_MODE protocol list extended with the three proof images. clk_config.vh: auto-generated output of the 50 MHz proof builds (previously 100 MHz).
    [emu_tt_loader.v, gen_fw_rom.py, sram_emu.v]
2026-10-28 imem512: rebuilt emu_tt_50 bitstream + Phase-6 Zybo proof logs
    emu_tt_50.bit/.ltx rebuilt from the widened design (the only emu_tt_* pair tracked; variant bitstreams stay ignored per .gitignore). Force-adds fpga/logs/test512_*.log + build512_summary.txt past the fpga/logs/ ignore: they are the hardware proof record -- SPI/UART/I2C/1-Wire PASS, SPI@125 PASS x2, merged USB (299 words) PASS, ubproof upper-bank PASS, usb_full301 PASS, vacuity control x2 plus the post-fix re-run. Adds test/cosim/hex/{ubproof,usb_full301}.hex, the proof-image co-sim inputs.
2026-10-29 docs: Phase-A functionality open-items audit 2026-10-29 (docs/readme-site)
    Audit every open item in SUBMISSION_READINESS_2026-10-27 and
    PUSH_PREP_AUDIT_2026-10-26 ss15-18; classify as impacts-functionality /
    documented-limitation / non-functional. T17 as-built behavior proven by
    tb_pe bench (256/4096 + CONFIG_ERR fallback; no wrap possible); CAN
    DLC<=2 bound; SPI checker 57->58/407->408 fix recorded as patch (golden
    tests live in local masters, re-run PASS); UART underrun documented as
    firmware blocking behavior; slow-corner clock guidance (<=43.8 MHz);
    SPI@125 observed-not-root-caused; Observer HW capture scoped as
    remaining score item (no RD_TRACE path in current Zybo harness).
    Docs-only: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
2026-10-29 docs: Phase B+C README rewrite + GitHub Pages site (docs/readme-site)
    README: rewritten with generated SVG diagrams (architecture, ISA word,
    timing contract, pin map, die/tiles, SPI/UART/I2C/USB waveforms),
    512-word spec table incl. honest slow-corner note, protocol verdicts,
    real SPI/USB firmware excerpts, host-use flow, test512 matrix, and the
    Phase-A limitations verbatim from CHARACTERIZED_LIMITS.
    Site (docs/, Pages-ready, no CDN deps): hero, architecture, spec,
    functionality matrix, waveforms, example code, how-to-use, FPGA
    testing, labeled 512 top view, 2D GDS explorer (16 layers, toggles,
    ISO, presets, pan/zoom, um probe, macro/pin overlays) and a canvas-2D
    isometric 3D exploded-stack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
2026-10-29 docs: interactive TEMPO simulator (cycle-exact web port, assembler, peers, examples)
    Browser port of the TEMPO-32 golden model (ISA v0.2 + v0.3 9-bit
    activation) with the as-built RTL divergences: WAIT tsel 2/3 fall back
    to 256/4096 cycles + CONFIG_ERR (no 65536/1048576 presets, no
    saturation); illegal opcodes / CALL overflow / RET underflow / AND
    fn=11 are NOP + CONFIG_ERR; Observer PULSE watches PIN 0 only;
    trace SRAM saturates at 204 entries, never wraps. In-browser
    assembler bit-identical to firmware/tools/asm.py on all 12 firmware
    sources; SPI and USB-merged pin histories match the golden model
    cycle-by-cycle (881 and 6297 ticks, zero divergence). Plain
    HTML/CSS/JS, zero external depend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
2026-10-29 docs: wire simulator into site nav + index
    nav.js (single nav definition) gains the Simulator page with
    index-relative anchors on the simulator page; index gains a Simulator
    card. No dead links: every asset reference on both pages resolves
    when served locally.
2026-10-29 docs: redesign simulator page as a modern playground UI
    Sticky transport bar with run-state badge, example picker as cards
    with proven-status chips, live-state dashboard grid, collapsible
    trace/die panels, keyboard shortcuts (Space/S/I/N/R, guarded
    against editor/input/button focus), both-theme token styling.
    Simulation behaviour untouched: all ids preserved, tempo-* modules
    unmodified, every control keeps its exact meaning.
2026-10-29 docs: fix simulator Speed pacing scope and stale example status
    Speed (cycles/sec) only ever paced the Free-run button, but the Run
    button and the Space shortcut both ran unpaced full-speed with no
    label saying so, so Speed looked non-functional. Space now starts
    paced Free-run (Run-until-HALT stays unpaced by design); the Speed
    field is labeled Speed (Free-run) and the caption states the scope.
    The howto status line was static HTML (SPI is loaded.) that no code
    ever updated; loadExample now updates it to the loaded example.
2026-10-29 ci: remove viewer job (Pages branch-mode conflict)
    The viewer job deploys the GDS viewer via actions/deploy-pages, which
    requires Pages source = GitHub Actions mode. This repo serves docs from
    Pages in branch mode (main/docs), so the deployment always failed with
    Missing environment; switching modes would let it overwrite the docs
    site. Viewer is redundant: the docs site has a GDS explorer + 3D stack.
2026-10-29 docs: fix die activity view, explorer pins, and 3D stack rendering
    Simulator die view: the 8 pad anchors span 26.88 um at a 3.84 um pitch,
    so 11 px circles overlapped 9x on desktop and 20x on a phone into one
    blob. Draw true-position ticks on the north edge plus a magnified pad
    row below the die (die order PIN7..PIN0, explicitly not to scale).
    Explorer: pins were 4 um-radius dots (8 um wide vs 3.84 um pitch, 2x
    overlap at any zoom, a red smear). Draw short outward ticks instead.
    Resize no longer refits (phone URL-bar resize yanked pan/zoom); draw()
    resyncs a drifted backing store; IntersectionObserver/pageshow/
    visibilitychange redraw so the canvas self-heals after navigation.
    3D stack: dr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
2026-10-29 docs: commit firmware tree + evidence docs (resolves citations)
    firmware/: protocol sources (spi, uart, i2c, onewire, jtag, swd, ps2,
    can, usb incl. usb_full 299w + usb_full301 + usb_rx_experiment),
    ubproof, tools (asm.py, sim.py, tb.py, record_cosim.py, selftest),
    tests (golden checkers + recorders) and hex/lst outputs. All sources
    verified: re-assembled with firmware/tools/asm.py to the exact known
    word counts (spi 71, uart 125, i2c 209, onewire 132, jtag 169,
    swd 111, ps2 216, can 255, usb-tx 243, usb_full 299, usb_full301 301,
    usb_rx_experiment 63) and byte-identical to the simulator embedded
    sources. Regenerated stale build products to match current sources:
    firmware/i2c/i2c.hex+.lst (w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
    [i2c.asm]
2026-10-29 ci: merged Pages deploy (docs site + Tiny Tapeout viewer at /viewer/)
    Single GitHub Actions deployment replaces the branch-mode site: docs/
    as the root plus viewer model files under viewer/ (tinytapeout.oas/.gds
    + render PNG from the latest successful gds run) and a landing page
    linking to Tiny Tapeout hosted 3D viewer and Explorer. The template
    viewer job cannot coexist with the docs site because deploy-pages
    replaces the whole site; merging is what makes both live together.
    Nav gains a GDS Viewer link. Requires Pages source = GitHub Actions
    mode (switch after merge, then workflow_dispatch this workflow).
2026-10-29 ci: fix viewer landing-page injection guard self-trigger
    The deploy sed replaces __PDK__ everywhere, including inside the old
    guard (PDK.indexOf("__PDK__")), which after injection reads
    PDK.indexOf("ihp-sg13cmos5l") and disables the buttons on the very
    page the deploy just configured. The guard now checks a separate
    deploy-time flag against its injected value ("yes"), which cannot
    self-trigger, and the assemble step fails if any placeholder survives
    injection. Verified in Node against the real assembled page: injected
    page builds correct Tiny Tapeout viewer/Explorer URLs; un-injected
    page still disables gracefully.
2026-10-29 ci: fix pages-deploy finder (gh api has no -e flag)
    The jobs lookup used `gh api ... --jq -e ...`, but `gh api` rejects
    the -e flag ("accepts 1 arg(s), received 2"), so the finder failed on
    every candidate and both first deploy attempts died in the find step
    (before ever reaching deploy). The lookup now prints the matching gds
    job id and greps for any output. Verified locally against the live
    API: the finder selects run 40881632344, whose gds job succeeded.
2026-10-29 docs: fix audit stale line + spi header 407/57 -> 408/58
    Audit item 3a now states the golden tests live in firmware/tests/ (committed), the masters: convention note reflects the committed firmware tree, and the spi header now says 408/58. Fresh assembly of spi.asm is still 71 words, byte-identical to firmware/tests/out/spi.hex.
2026-10-29 docs: rebrand TEMPO to Tarang (full rebrand, prose + headers)
    Whole-word project-name rename only: Tempo/TEMPO -> Tarang (incl. TEMPO-32 -> Tarang-32), 89 files, pure substitutions. Identifiers, file names, keys, and tt_um_pemu untouched; tempo-theme key, tempo-theme-init marker, and tempo-*.js references deliberately kept. Diagrams regenerated from the renamed generator (light + dark). Firmware re-assembled byte-identical to committed hex; 13-example simulator sweep tick-exact. Also fixes the embedded SPI source in tempo-examples.js: it still said 407 cycles (stale since the 408 audit fix) while firmware/spi/spi.asm says 408; the 3 comment lines now match firmware.
    [emu_loader.v, i2c.asm]
